natsutan/sting/vivado/zybo/zybo_sting/zybo_sting.ip_user_files/README.txt

The files in this directory structure are automatically generated and managed by Vivado. Editing these files is not recommended.
