natsutan/sting/vivado/zybo/sting_ip/sting_ip.srcs/sources_1/bd/design_1/ip/design_1_axi_vip_1_1/design_1_axi_vip_1_1_stub.v

// Copyright 1986-2017 Xilinx, Inc. All Rights Reserved.
// --------------------------------------------------------------------------------
// Tool Version: Vivado v.2017.2 (win64) Build 1909853 Thu Jun 15 18:39:09 MDT 2017
// Date        : Wed Dec 13 14:37:22 2017
// Host        : LAPTOP-NDAAQDUA running 64-bit major release  (build 9200)
// Command     : write_verilog -force -mode synth_stub
//               C:/home/myproj/sting/vivado/zybo/sting_ip/sting_ip.srcs/sources_1/bd/design_1/ip/design_1_axi_vip_1_1/design_1_axi_vip_1_1_stub.v
// Design      : design_1_axi_vip_1_1
// Purpose     : Stub declaration of top-level module interface
// Device      : xc7z010clg400-1
// --------------------------------------------------------------------------------

// This empty module with port declaration file causes synthesis tools to infer a black box for IP.
// The synthesis directives are for Synopsys Synplify support to prevent IO buffer insertion.
// Please paste the declaration into a Verilog source file or add the file as an additional source.
(* X_CORE_INFO = "axi_vip_v1_0_2_top,Vivado 2017.2" *)
module design_1_axi_vip_1_1(aclk, aresetn, s_axi_awid, s_axi_awaddr, 
  s_axi_awlen, s_axi_awburst, s_axi_awlock, s_axi_awcache, s_axi_awprot, s_axi_awqos, 
  s_axi_awuser, s_axi_awvalid, s_axi_awready, s_axi_wdata, s_axi_wstrb, s_axi_wlast, 
  s_axi_wuser, s_axi_wvalid, s_axi_wready, s_axi_bid, s_axi_bresp, s_axi_buser, s_axi_bvalid, 
  s_axi_bready, s_axi_arid, s_axi_araddr, s_axi_arlen, s_axi_arburst, s_axi_arlock, 
  s_axi_arcache, s_axi_arprot, s_axi_arqos, s_axi_aruser, s_axi_arvalid, s_axi_arready, 
  s_axi_rid, s_axi_rdata, s_axi_rresp, s_axi_rlast, s_axi_ruser, s_axi_rvalid, s_axi_rready)
/* synthesis syn_black_box black_box_pad_pin="aclk,aresetn,s_axi_awid[0:0],s_axi_awaddr[31:0],s_axi_awlen[7:0],s_axi_awburst[1:0],s_axi_awlock[0:0],s_axi_awcache[3:0],s_axi_awprot[2:0],s_axi_awqos[3:0],s_axi_awuser[0:0],s_axi_awvalid,s_axi_awready,s_axi_wdata[31:0],s_axi_wstrb[3:0],s_axi_wlast,s_axi_wuser[0:0],s_axi_wvalid,s_axi_wready,s_axi_bid[0:0],s_axi_bresp[1:0],s_axi_buser[0:0],s_axi_bvalid,s_axi_bready,s_axi_arid[0:0],s_axi_araddr[31:0],s_axi_arlen[7:0],s_axi_arburst[1:0],s_axi_arlock[0:0],s_axi_arcache[3:0],s_axi_arprot[2:0],s_axi_arqos[3:0],s_axi_aruser[0:0],s_axi_arvalid,s_axi_arready,s_axi_rid[0:0],s_axi_rdata[31:0],s_axi_rresp[1:0],s_axi_rlast,s_axi_ruser[0:0],s_axi_rvalid,s_axi_rready" */;
  input aclk;
  input aresetn;
  input [0:0]s_axi_awid;
  input [31:0]s_axi_awaddr;
  input [7:0]s_axi_awlen;
  input [1:0]s_axi_awburst;
  input [0:0]s_axi_awlock;
  input [3:0]s_axi_awcache;
  input [2:0]s_axi_awprot;
  input [3:0]s_axi_awqos;
  input [0:0]s_axi_awuser;
  input s_axi_awvalid;
  output s_axi_awready;
  input [31:0]s_axi_wdata;
  input [3:0]s_axi_wstrb;
  input s_axi_wlast;
  input [0:0]s_axi_wuser;
  input s_axi_wvalid;
  output s_axi_wready;
  output [0:0]s_axi_bid;
  output [1:0]s_axi_bresp;
  output [0:0]s_axi_buser;
  output s_axi_bvalid;
  input s_axi_bready;
  input [0:0]s_axi_arid;
  input [31:0]s_axi_araddr;
  input [7:0]s_axi_arlen;
  input [1:0]s_axi_arburst;
  input [0:0]s_axi_arlock;
  input [3:0]s_axi_arcache;
  input [2:0]s_axi_arprot;
  input [3:0]s_axi_arqos;
  input [0:0]s_axi_aruser;
  input s_axi_arvalid;
  output s_axi_arready;
  output [0:0]s_axi_rid;
  output [31:0]s_axi_rdata;
  output [1:0]s_axi_rresp;
  output s_axi_rlast;
  output [0:0]s_axi_ruser;
  output s_axi_rvalid;
  input s_axi_rready;
endmodule
