natsutan/sting/vivado/zybo/ip_repo/sting_wrap_1.0/src/float_mul/float_mul_sim_netlist.v

// Copyright 1986-2017 Xilinx, Inc. All Rights Reserved.
// --------------------------------------------------------------------------------
// Tool Version: Vivado v.2017.2 (win64) Build 1909853 Thu Jun 15 18:39:09 MDT 2017
// Date        : Mon Nov 27 00:59:39 2017
// Host        : LAPTOP-NDAAQDUA running 64-bit major release  (build 9200)
// Command     : write_verilog -force -mode funcsim
//               c:/home/myproj/sting/vivado/zybo/ip_repo/sting_wrap_1.0/src/float_mul/float_mul_sim_netlist.v
// Design      : float_mul
// Purpose     : This verilog netlist is a functional simulation representation of the design and should not be modified
//               or synthesized. This netlist cannot be used for SDF annotated simulation.
// Device      : xc7z010clg400-1
// --------------------------------------------------------------------------------
`timescale 1 ps / 1 ps

(* CHECK_LICENSE_TYPE = "float_mul,floating_point_v7_1_4,{}" *) (* downgradeipidentifiedwarnings = "yes" *) (* x_core_info = "floating_point_v7_1_4,Vivado 2017.2" *) 
(* NotValidForBitStream *)
module float_mul
   (aclk,
    s_axis_a_tvalid,
    s_axis_a_tdata,
    s_axis_b_tvalid,
    s_axis_b_tdata,
    m_axis_result_tvalid,
    m_axis_result_tdata);
  (* x_interface_info = "xilinx.com:signal:clock:1.0 aclk_intf CLK" *) input aclk;
  (* x_interface_info = "xilinx.com:interface:axis:1.0 S_AXIS_A TVALID" *) input s_axis_a_tvalid;
  (* x_interface_info = "xilinx.com:interface:axis:1.0 S_AXIS_A TDATA" *) input [31:0]s_axis_a_tdata;
  (* x_interface_info = "xilinx.com:interface:axis:1.0 S_AXIS_B TVALID" *) input s_axis_b_tvalid;
  (* x_interface_info = "xilinx.com:interface:axis:1.0 S_AXIS_B TDATA" *) input [31:0]s_axis_b_tdata;
  (* x_interface_info = "xilinx.com:interface:axis:1.0 M_AXIS_RESULT TVALID" *) output m_axis_result_tvalid;
  (* x_interface_info = "xilinx.com:interface:axis:1.0 M_AXIS_RESULT TDATA" *) output [31:0]m_axis_result_tdata;

  wire aclk;
  wire [31:0]m_axis_result_tdata;
  wire m_axis_result_tvalid;
  wire [31:0]s_axis_a_tdata;
  wire s_axis_a_tvalid;
  wire [31:0]s_axis_b_tdata;
  wire s_axis_b_tvalid;
  wire NLW_U0_m_axis_result_tlast_UNCONNECTED;
  wire NLW_U0_s_axis_a_tready_UNCONNECTED;
  wire NLW_U0_s_axis_b_tready_UNCONNECTED;
  wire NLW_U0_s_axis_c_tready_UNCONNECTED;
  wire NLW_U0_s_axis_operation_tready_UNCONNECTED;
  wire [0:0]NLW_U0_m_axis_result_tuser_UNCONNECTED;

  (* C_ACCUM_INPUT_MSB = "32" *) 
  (* C_ACCUM_LSB = "-31" *) 
  (* C_ACCUM_MSB = "32" *) 
  (* C_A_FRACTION_WIDTH = "24" *) 
  (* C_A_TDATA_WIDTH = "32" *) 
  (* C_A_TUSER_WIDTH = "1" *) 
  (* C_A_WIDTH = "32" *) 
  (* C_BRAM_USAGE = "0" *) 
  (* C_B_FRACTION_WIDTH = "24" *) 
  (* C_B_TDATA_WIDTH = "32" *) 
  (* C_B_TUSER_WIDTH = "1" *) 
  (* C_B_WIDTH = "32" *) 
  (* C_COMPARE_OPERATION = "8" *) 
  (* C_C_FRACTION_WIDTH = "24" *) 
  (* C_C_TDATA_WIDTH = "32" *) 
  (* C_C_TUSER_WIDTH = "1" *) 
  (* C_C_WIDTH = "32" *) 
  (* C_FIXED_DATA_UNSIGNED = "0" *) 
  (* C_HAS_ABSOLUTE = "0" *) 
  (* C_HAS_ACCUMULATOR_A = "0" *) 
  (* C_HAS_ACCUMULATOR_S = "0" *) 
  (* C_HAS_ACCUM_INPUT_OVERFLOW = "0" *) 
  (* C_HAS_ACCUM_OVERFLOW = "0" *) 
  (* C_HAS_ACLKEN = "0" *) 
  (* C_HAS_ADD = "0" *) 
  (* C_HAS_ARESETN = "0" *) 
  (* C_HAS_A_TLAST = "0" *) 
  (* C_HAS_A_TUSER = "0" *) 
  (* C_HAS_B = "1" *) 
  (* C_HAS_B_TLAST = "0" *) 
  (* C_HAS_B_TUSER = "0" *) 
  (* C_HAS_C = "0" *) 
  (* C_HAS_COMPARE = "0" *) 
  (* C_HAS_C_TLAST = "0" *) 
  (* C_HAS_C_TUSER = "0" *) 
  (* C_HAS_DIVIDE = "0" *) 
  (* C_HAS_DIVIDE_BY_ZERO = "0" *) 
  (* C_HAS_EXPONENTIAL = "0" *) 
  (* C_HAS_FIX_TO_FLT = "0" *) 
  (* C_HAS_FLT_TO_FIX = "0" *) 
  (* C_HAS_FLT_TO_FLT = "0" *) 
  (* C_HAS_FMA = "0" *) 
  (* C_HAS_FMS = "0" *) 
  (* C_HAS_INVALID_OP = "0" *) 
  (* C_HAS_LOGARITHM = "0" *) 
  (* C_HAS_MULTIPLY = "1" *) 
  (* C_HAS_OPERATION = "0" *) 
  (* C_HAS_OPERATION_TLAST = "0" *) 
  (* C_HAS_OPERATION_TUSER = "0" *) 
  (* C_HAS_OVERFLOW = "0" *) 
  (* C_HAS_RECIP = "0" *) 
  (* C_HAS_RECIP_SQRT = "0" *) 
  (* C_HAS_RESULT_TLAST = "0" *) 
  (* C_HAS_RESULT_TUSER = "0" *) 
  (* C_HAS_SQRT = "0" *) 
  (* C_HAS_SUBTRACT = "0" *) 
  (* C_HAS_UNDERFLOW = "0" *) 
  (* C_LATENCY = "8" *) 
  (* C_MULT_USAGE = "1" *) 
  (* C_OPERATION_TDATA_WIDTH = "8" *) 
  (* C_OPERATION_TUSER_WIDTH = "1" *) 
  (* C_OPTIMIZATION = "1" *) 
  (* C_RATE = "1" *) 
  (* C_RESULT_FRACTION_WIDTH = "24" *) 
  (* C_RESULT_TDATA_WIDTH = "32" *) 
  (* C_RESULT_TUSER_WIDTH = "1" *) 
  (* C_RESULT_WIDTH = "32" *) 
  (* C_THROTTLE_SCHEME = "3" *) 
  (* C_TLAST_RESOLUTION = "0" *) 
  (* C_XDEVICEFAMILY = "zynq" *) 
  (* downgradeipidentifiedwarnings = "yes" *) 
  float_mul_floating_point_v7_1_4 U0
       (.aclk(aclk),
        .aclken(1'b1),
        .aresetn(1'b1),
        .m_axis_result_tdata(m_axis_result_tdata),
        .m_axis_result_tlast(NLW_U0_m_axis_result_tlast_UNCONNECTED),
        .m_axis_result_tready(1'b0),
        .m_axis_result_tuser(NLW_U0_m_axis_result_tuser_UNCONNECTED[0]),
        .m_axis_result_tvalid(m_axis_result_tvalid),
        .s_axis_a_tdata(s_axis_a_tdata),
        .s_axis_a_tlast(1'b0),
        .s_axis_a_tready(NLW_U0_s_axis_a_tready_UNCONNECTED),
        .s_axis_a_tuser(1'b0),
        .s_axis_a_tvalid(s_axis_a_tvalid),
        .s_axis_b_tdata(s_axis_b_tdata),
        .s_axis_b_tlast(1'b0),
        .s_axis_b_tready(NLW_U0_s_axis_b_tready_UNCONNECTED),
        .s_axis_b_tuser(1'b0),
        .s_axis_b_tvalid(s_axis_b_tvalid),
        .s_axis_c_tdata({1'b0,1'b0,1'b0,1'b0,1'b0,1'b0,1'b0,1'b0,1'b0,1'b0,1'b0,1'b0,1'b0,1'b0,1'b0,1'b0,1'b0,1'b0,1'b0,1'b0,1'b0,1'b0,1'b0,1'b0,1'b0,1'b0,1'b0,1'b0,1'b0,1'b0,1'b0,1'b0}),
        .s_axis_c_tlast(1'b0),
        .s_axis_c_tready(NLW_U0_s_axis_c_tready_UNCONNECTED),
        .s_axis_c_tuser(1'b0),
        .s_axis_c_tvalid(1'b0),
        .s_axis_operation_tdata({1'b0,1'b0,1'b0,1'b0,1'b0,1'b0,1'b0,1'b0}),
        .s_axis_operation_tlast(1'b0),
        .s_axis_operation_tready(NLW_U0_s_axis_operation_tready_UNCONNECTED),
        .s_axis_operation_tuser(1'b0),
        .s_axis_operation_tvalid(1'b0));
endmodule

(* C_ACCUM_INPUT_MSB = "32" *) (* C_ACCUM_LSB = "-31" *) (* C_ACCUM_MSB = "32" *) 
(* C_A_FRACTION_WIDTH = "24" *) (* C_A_TDATA_WIDTH = "32" *) (* C_A_TUSER_WIDTH = "1" *) 
(* C_A_WIDTH = "32" *) (* C_BRAM_USAGE = "0" *) (* C_B_FRACTION_WIDTH = "24" *) 
(* C_B_TDATA_WIDTH = "32" *) (* C_B_TUSER_WIDTH = "1" *) (* C_B_WIDTH = "32" *) 
(* C_COMPARE_OPERATION = "8" *) (* C_C_FRACTION_WIDTH = "24" *) (* C_C_TDATA_WIDTH = "32" *) 
(* C_C_TUSER_WIDTH = "1" *) (* C_C_WIDTH = "32" *) (* C_FIXED_DATA_UNSIGNED = "0" *) 
(* C_HAS_ABSOLUTE = "0" *) (* C_HAS_ACCUMULATOR_A = "0" *) (* C_HAS_ACCUMULATOR_S = "0" *) 
(* C_HAS_ACCUM_INPUT_OVERFLOW = "0" *) (* C_HAS_ACCUM_OVERFLOW = "0" *) (* C_HAS_ACLKEN = "0" *) 
(* C_HAS_ADD = "0" *) (* C_HAS_ARESETN = "0" *) (* C_HAS_A_TLAST = "0" *) 
(* C_HAS_A_TUSER = "0" *) (* C_HAS_B = "1" *) (* C_HAS_B_TLAST = "0" *) 
(* C_HAS_B_TUSER = "0" *) (* C_HAS_C = "0" *) (* C_HAS_COMPARE = "0" *) 
(* C_HAS_C_TLAST = "0" *) (* C_HAS_C_TUSER = "0" *) (* C_HAS_DIVIDE = "0" *) 
(* C_HAS_DIVIDE_BY_ZERO = "0" *) (* C_HAS_EXPONENTIAL = "0" *) (* C_HAS_FIX_TO_FLT = "0" *) 
(* C_HAS_FLT_TO_FIX = "0" *) (* C_HAS_FLT_TO_FLT = "0" *) (* C_HAS_FMA = "0" *) 
(* C_HAS_FMS = "0" *) (* C_HAS_INVALID_OP = "0" *) (* C_HAS_LOGARITHM = "0" *) 
(* C_HAS_MULTIPLY = "1" *) (* C_HAS_OPERATION = "0" *) (* C_HAS_OPERATION_TLAST = "0" *) 
(* C_HAS_OPERATION_TUSER = "0" *) (* C_HAS_OVERFLOW = "0" *) (* C_HAS_RECIP = "0" *) 
(* C_HAS_RECIP_SQRT = "0" *) (* C_HAS_RESULT_TLAST = "0" *) (* C_HAS_RESULT_TUSER = "0" *) 
(* C_HAS_SQRT = "0" *) (* C_HAS_SUBTRACT = "0" *) (* C_HAS_UNDERFLOW = "0" *) 
(* C_LATENCY = "8" *) (* C_MULT_USAGE = "1" *) (* C_OPERATION_TDATA_WIDTH = "8" *) 
(* C_OPERATION_TUSER_WIDTH = "1" *) (* C_OPTIMIZATION = "1" *) (* C_RATE = "1" *) 
(* C_RESULT_FRACTION_WIDTH = "24" *) (* C_RESULT_TDATA_WIDTH = "32" *) (* C_RESULT_TUSER_WIDTH = "1" *) 
(* C_RESULT_WIDTH = "32" *) (* C_THROTTLE_SCHEME = "3" *) (* C_TLAST_RESOLUTION = "0" *) 
(* C_XDEVICEFAMILY = "zynq" *) (* ORIG_REF_NAME = "floating_point_v7_1_4" *) (* downgradeipidentifiedwarnings = "yes" *) 
module float_mul_floating_point_v7_1_4
   (aclk,
    aclken,
    aresetn,
    s_axis_a_tvalid,
    s_axis_a_tready,
    s_axis_a_tdata,
    s_axis_a_tuser,
    s_axis_a_tlast,
    s_axis_b_tvalid,
    s_axis_b_tready,
    s_axis_b_tdata,
    s_axis_b_tuser,
    s_axis_b_tlast,
    s_axis_c_tvalid,
    s_axis_c_tready,
    s_axis_c_tdata,
    s_axis_c_tuser,
    s_axis_c_tlast,
    s_axis_operation_tvalid,
    s_axis_operation_tready,
    s_axis_operation_tdata,
    s_axis_operation_tuser,
    s_axis_operation_tlast,
    m_axis_result_tvalid,
    m_axis_result_tready,
    m_axis_result_tdata,
    m_axis_result_tuser,
    m_axis_result_tlast);
  input aclk;
  input aclken;
  input aresetn;
  input s_axis_a_tvalid;
  output s_axis_a_tready;
  input [31:0]s_axis_a_tdata;
  input [0:0]s_axis_a_tuser;
  input s_axis_a_tlast;
  input s_axis_b_tvalid;
  output s_axis_b_tready;
  input [31:0]s_axis_b_tdata;
  input [0:0]s_axis_b_tuser;
  input s_axis_b_tlast;
  input s_axis_c_tvalid;
  output s_axis_c_tready;
  input [31:0]s_axis_c_tdata;
  input [0:0]s_axis_c_tuser;
  input s_axis_c_tlast;
  input s_axis_operation_tvalid;
  output s_axis_operation_tready;
  input [7:0]s_axis_operation_tdata;
  input [0:0]s_axis_operation_tuser;
  input s_axis_operation_tlast;
  output m_axis_result_tvalid;
  input m_axis_result_tready;
  output [31:0]m_axis_result_tdata;
  output [0:0]m_axis_result_tuser;
  output m_axis_result_tlast;

  wire \<const0> ;
  wire \<const1> ;
  wire aclk;
  wire [31:0]m_axis_result_tdata;
  wire m_axis_result_tvalid;
  wire [31:0]s_axis_a_tdata;
  wire s_axis_a_tvalid;
  wire [31:0]s_axis_b_tdata;
  wire s_axis_b_tvalid;
  wire NLW_i_synth_m_axis_result_tlast_UNCONNECTED;
  wire NLW_i_synth_s_axis_a_tready_UNCONNECTED;
  wire NLW_i_synth_s_axis_b_tready_UNCONNECTED;
  wire NLW_i_synth_s_axis_c_tready_UNCONNECTED;
  wire NLW_i_synth_s_axis_operation_tready_UNCONNECTED;
  wire [0:0]NLW_i_synth_m_axis_result_tuser_UNCONNECTED;

  assign m_axis_result_tlast = \<const0> ;
  assign m_axis_result_tuser[0] = \<const0> ;
  assign s_axis_a_tready = \<const1> ;
  assign s_axis_b_tready = \<const1> ;
  assign s_axis_c_tready = \<const1> ;
  assign s_axis_operation_tready = \<const1> ;
  GND GND
       (.G(\<const0> ));
  VCC VCC
       (.P(\<const1> ));
  (* C_ACCUM_INPUT_MSB = "32" *) 
  (* C_ACCUM_LSB = "-31" *) 
  (* C_ACCUM_MSB = "32" *) 
  (* C_A_FRACTION_WIDTH = "24" *) 
  (* C_A_TDATA_WIDTH = "32" *) 
  (* C_A_TUSER_WIDTH = "1" *) 
  (* C_A_WIDTH = "32" *) 
  (* C_BRAM_USAGE = "0" *) 
  (* C_B_FRACTION_WIDTH = "24" *) 
  (* C_B_TDATA_WIDTH = "32" *) 
  (* C_B_TUSER_WIDTH = "1" *) 
  (* C_B_WIDTH = "32" *) 
  (* C_COMPARE_OPERATION = "8" *) 
  (* C_C_FRACTION_WIDTH = "24" *) 
  (* C_C_TDATA_WIDTH = "32" *) 
  (* C_C_TUSER_WIDTH = "1" *) 
  (* C_C_WIDTH = "32" *) 
  (* C_FIXED_DATA_UNSIGNED = "0" *) 
  (* C_HAS_ABSOLUTE = "0" *) 
  (* C_HAS_ACCUMULATOR_A = "0" *) 
  (* C_HAS_ACCUMULATOR_S = "0" *) 
  (* C_HAS_ACCUM_INPUT_OVERFLOW = "0" *) 
  (* C_HAS_ACCUM_OVERFLOW = "0" *) 
  (* C_HAS_ACLKEN = "0" *) 
  (* C_HAS_ADD = "0" *) 
  (* C_HAS_ARESETN = "0" *) 
  (* C_HAS_A_TLAST = "0" *) 
  (* C_HAS_A_TUSER = "0" *) 
  (* C_HAS_B = "1" *) 
  (* C_HAS_B_TLAST = "0" *) 
  (* C_HAS_B_TUSER = "0" *) 
  (* C_HAS_C = "0" *) 
  (* C_HAS_COMPARE = "0" *) 
  (* C_HAS_C_TLAST = "0" *) 
  (* C_HAS_C_TUSER = "0" *) 
  (* C_HAS_DIVIDE = "0" *) 
  (* C_HAS_DIVIDE_BY_ZERO = "0" *) 
  (* C_HAS_EXPONENTIAL = "0" *) 
  (* C_HAS_FIX_TO_FLT = "0" *) 
  (* C_HAS_FLT_TO_FIX = "0" *) 
  (* C_HAS_FLT_TO_FLT = "0" *) 
  (* C_HAS_FMA = "0" *) 
  (* C_HAS_FMS = "0" *) 
  (* C_HAS_INVALID_OP = "0" *) 
  (* C_HAS_LOGARITHM = "0" *) 
  (* C_HAS_MULTIPLY = "1" *) 
  (* C_HAS_OPERATION = "0" *) 
  (* C_HAS_OPERATION_TLAST = "0" *) 
  (* C_HAS_OPERATION_TUSER = "0" *) 
  (* C_HAS_OVERFLOW = "0" *) 
  (* C_HAS_RECIP = "0" *) 
  (* C_HAS_RECIP_SQRT = "0" *) 
  (* C_HAS_RESULT_TLAST = "0" *) 
  (* C_HAS_RESULT_TUSER = "0" *) 
  (* C_HAS_SQRT = "0" *) 
  (* C_HAS_SUBTRACT = "0" *) 
  (* C_HAS_UNDERFLOW = "0" *) 
  (* C_LATENCY = "8" *) 
  (* C_MULT_USAGE = "1" *) 
  (* C_OPERATION_TDATA_WIDTH = "8" *) 
  (* C_OPERATION_TUSER_WIDTH = "1" *) 
  (* C_OPTIMIZATION = "1" *) 
  (* C_RATE = "1" *) 
  (* C_RESULT_FRACTION_WIDTH = "24" *) 
  (* C_RESULT_TDATA_WIDTH = "32" *) 
  (* C_RESULT_TUSER_WIDTH = "1" *) 
  (* C_RESULT_WIDTH = "32" *) 
  (* C_THROTTLE_SCHEME = "3" *) 
  (* C_TLAST_RESOLUTION = "0" *) 
  (* C_XDEVICEFAMILY = "zynq" *) 
  (* downgradeipidentifiedwarnings = "yes" *) 
  float_mul_floating_point_v7_1_4_viv i_synth
       (.aclk(aclk),
        .aclken(1'b0),
        .aresetn(1'b0),
        .m_axis_result_tdata(m_axis_result_tdata),
        .m_axis_result_tlast(NLW_i_synth_m_axis_result_tlast_UNCONNECTED),
        .m_axis_result_tready(1'b0),
        .m_axis_result_tuser(NLW_i_synth_m_axis_result_tuser_UNCONNECTED[0]),
        .m_axis_result_tvalid(m_axis_result_tvalid),
        .s_axis_a_tdata(s_axis_a_tdata),
        .s_axis_a_tlast(1'b0),
        .s_axis_a_tready(NLW_i_synth_s_axis_a_tready_UNCONNECTED),
        .s_axis_a_tuser(1'b0),
        .s_axis_a_tvalid(s_axis_a_tvalid),
        .s_axis_b_tdata(s_axis_b_tdata),
        .s_axis_b_tlast(1'b0),
        .s_axis_b_tready(NLW_i_synth_s_axis_b_tready_UNCONNECTED),
        .s_axis_b_tuser(1'b0),
        .s_axis_b_tvalid(s_axis_b_tvalid),
        .s_axis_c_tdata({1'b0,1'b0,1'b0,1'b0,1'b0,1'b0,1'b0,1'b0,1'b0,1'b0,1'b0,1'b0,1'b0,1'b0,1'b0,1'b0,1'b0,1'b0,1'b0,1'b0,1'b0,1'b0,1'b0,1'b0,1'b0,1'b0,1'b0,1'b0,1'b0,1'b0,1'b0,1'b0}),
        .s_axis_c_tlast(1'b0),
        .s_axis_c_tready(NLW_i_synth_s_axis_c_tready_UNCONNECTED),
        .s_axis_c_tuser(1'b0),
        .s_axis_c_tvalid(1'b0),
        .s_axis_operation_tdata({1'b0,1'b0,1'b0,1'b0,1'b0,1'b0,1'b0,1'b0}),
        .s_axis_operation_tlast(1'b0),
        .s_axis_operation_tready(NLW_i_synth_s_axis_operation_tready_UNCONNECTED),
        .s_axis_operation_tuser(1'b0),
        .s_axis_operation_tvalid(1'b0));
endmodule
`pragma protect begin_protected
`pragma protect version = 1
`pragma protect encrypt_agent = "XILINX"
`pragma protect encrypt_agent_info = "Xilinx Encryption Tool 2015"
`pragma protect key_keyowner="Cadence Design Systems.", key_keyname="cds_rsa_key", key_method="rsa"
`pragma protect encoding = (enctype="BASE64", line_length=76, bytes=64)
`pragma protect key_block
gMnNDB7HJ7donIJbcM6QEJhs7GvsLZQGaLvOD/fPlyeIjj7Rj/lJ4gT0tXZQEcBxPDk1lgtQTzhA
aTf8smsH3w==

`pragma protect key_keyowner="Mentor Graphics Corporation", key_keyname="MGC-VERIF-SIM-RSA-1", key_method="rsa"
`pragma protect encoding = (enctype="BASE64", line_length=76, bytes=128)
`pragma protect key_block
k6o4s8ezPOdGLPCxBhj7yeIjEH8po60eJ5YNYMKGXXYdLD898CcAAw0EvrHsivJvDr0ryU+aVO4w
CWcCTxUt8pReAUAa9H9+RdDfSxUQb03nJOyGX2wJS6DEELXD1eq/OEehI/ziKnZ59rBG0UIIgZvC
yPtECONoLcc2TBKYb6c=

`pragma protect key_keyowner="Synopsys", key_keyname="SNPS-VCS-RSA-1", key_method="rsa"
`pragma protect encoding = (enctype="BASE64", line_length=76, bytes=128)
`pragma protect key_block
MZA/t6b5vV7s0J+J5RLdbP6PHUxxDkvU08bTG1vLsBX67qKX4U+C3Wsx6TNN0okYEct8Xkhb289N
JtbWq4kXIQYcn4CwCvLm8yhSxQ2XwXJns7fUib9wYsgXQ3rnAGFrKv1HuyFXVcOBtfP2wkYqXpeD
CTyvlqfurrqUWmQ7UKk=

`pragma protect key_keyowner="Aldec", key_keyname="ALDEC15_001", key_method="rsa"
`pragma protect encoding = (enctype="BASE64", line_length=76, bytes=256)
`pragma protect key_block
Mp+/Q6a3N6nCHeNhCdRUBgQqepFSqeLYU4EqRdXf6mDSGy/4oTzTrCxFpZcmf7PS2LUou6tA6wBP
eCGOEZslD/aY7bVbNvSz1gv2x2NkzOuEi6ryFILivy6r7eSfTN1a1uYk48oGl70aYtw6LHTredUU
eFovuGVMSp1e3Zh66f7vArqfO6zDJlwXnKW+B1DNyWj4p929QNU2+RN0enU+E1S4wm7g5+0BgdT+
rmPX0Jsl0bIWKAIzRzlmvcNvzsFtlNgnuNJ+GKCL6+tseDcn5Z8u42lKQqVT6MjqDn/VQgGHNsfM
VBfZdVLsbkAkwAlXVZOcdCxuw79rVZcpJhYJGg==

`pragma protect key_keyowner="ATRENTA", key_keyname="ATR-SG-2015-RSA-3", key_method="rsa"
`pragma protect encoding = (enctype="BASE64", line_length=76, bytes=256)
`pragma protect key_block
YIEIm2lOi+fRHHM+EO3dxSj9n30vPGFIo8XEFyIzZoZAMHs1UOzKM23/GkgzZxBFxJfMyS/d7ArR
WRjQ8UXAmzk4HktLauXbBeWobuq4mV6lDpTjn77TXtZtpxauNJv/aYAdtjdPI3KDUQCs7szWuaet
9ydMZarsImfgB0Y5UfmropJ7T6Am0oAgn1P1KQ+WuIEQ236WOk9UPmVeKORSrq5f1NAh+Y3QJX/r
HDbglZ2bVDSwPmnMSAShLLojJrd87TRlcODcA2mbQB/VzBkBdCdMlziL7Zv2e/8a0f8S8ZY6KkNe
P4g3C+zb0R7FWBPpKdhuwgod8I1RIyoCzGsIfg==

`pragma protect key_keyowner="Xilinx", key_keyname="xilinx_2016_05", key_method="rsa"
`pragma protect encoding = (enctype="BASE64", line_length=76, bytes=256)
`pragma protect key_block
Ol11igo6uicyQPMv3TYh1e1YZsG97VgcnA0AsEZ4d4vgXZ98mVZHNSPN/7odE2GZE1OrUsPN+DcN
Bzi1mQW4iJ6zTFV0CUlTQ3GPjgKMf2jmTfTENWjprFYdcW+NW2siwWbCP+FCVAS7ytx/FWuRYwSI
8BI1VqamYS2FUnk4WzsF4HwMShp3QNuWuVKvbjsikYPj6EVkt8zba31pUhT151lw/GGlvD2nj+wF
VXr/XYoQCJuXCKDWw7Gh2mkeHRpvS1rwiQtutUNoIRN9gcL8Ti2cnaxEHmdAY6Rs/QJsznVWLgzm
pLckE1T683mQn4gGbbtKAASGBxVM5hQyK5VEjg==

`pragma protect key_keyowner="Mentor Graphics Corporation", key_keyname="MGC-PREC-RSA", key_method="rsa"
`pragma protect encoding = (enctype="base64", line_length=76, bytes=256)
`pragma protect key_block
MUQ7fRa/H45SILniL07Vwx1ShdRaTSVaDxGG215umWqkK/ui1H9Myqx04LoWTXNyBP1zxsRpJUO0
F7eMkTaxG5Fdz9wjR71WL52tL/ZywaAPv7VbBxmcjIEWzDXYSE1c/HAx9+xneua03AukERkIr0Hb
z69ZUyqOVUjn5PnP6TxzJoXomsLWPEH224w0J2ivHJD6NnXVRPLxMY7XoX62SifVYzXgwYfrMlIO
WT6DROyVd2MJ25sySeS5b3KtjejLR1Fq3EVHbCA95hj+/O/EcEdQVZW397VitN5BwAWgNb5ykujH
tG1Yw3AFRwWtelHt1FwrPHzyZRroq+5hoN9Q3w==

`pragma protect key_keyowner="Synplicity", key_keyname="SYNP15_1", key_method="rsa"
`pragma protect encoding = (enctype="base64", line_length=76, bytes=256)
`pragma protect key_block
icKqGC+FyncnGj/Z16fMBPy61Ql9p6giCgTNaGZIfLVhBsp76nNn8iRYgvMRixZvPYclZWjLiN6O
kp1i5piy+bxWqB7GTYaQbk+BIm2VGo3RMBKmf1PkNTuISVEwILNsHAmJfyhjhcN+F7JoSNDp6j2M
vouKQkkosrnQlOESFHAB/gOfkSsxnSCybEZxM2gJVWVIu+Q1mfMu4cVhbvgEcfmqoXJvDK7zyYJh
dje2OUc6GPpLVd0EMIMOJAov4qh/EzCCUh/uL2CwssoLYczlaGW2fe37rjmegLp7wCeFjZnIH1JB
uITnGGHoi3u5ieqliAJov4b3DVRWfnpOvsCqoQ==

`pragma protect data_method = "AES128-CBC"
`pragma protect encoding = (enctype = "BASE64", line_length = 76, bytes = 336624)
`pragma protect data_block
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
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
