natsutan/sting/vivado/zybo/sting_ip/sting_ip.srcs/sources_1/bd/design_1/ip/design_1_axi_vip_0_1/design_1_axi_vip_0_1_sim_netlist.v

// Copyright 1986-2017 Xilinx, Inc. All Rights Reserved.
// --------------------------------------------------------------------------------
// Tool Version: Vivado v.2017.2 (win64) Build 1909853 Thu Jun 15 18:39:09 MDT 2017
// Date        : Wed Dec 13 14:36:33 2017
// Host        : LAPTOP-NDAAQDUA running 64-bit major release  (build 9200)
// Command     : write_verilog -force -mode funcsim
//               C:/home/myproj/sting/vivado/zybo/sting_ip/sting_ip.srcs/sources_1/bd/design_1/ip/design_1_axi_vip_0_1/design_1_axi_vip_0_1_sim_netlist.v
// Design      : design_1_axi_vip_0_1
// Purpose     : This verilog netlist is a functional simulation representation of the design and should not be modified
//               or synthesized. This netlist cannot be used for SDF annotated simulation.
// Device      : xc7z010clg400-1
// --------------------------------------------------------------------------------
`timescale 1 ps / 1 ps

(* CHECK_LICENSE_TYPE = "design_1_axi_vip_0_1,axi_vip_v1_0_2_top,{}" *) (* DowngradeIPIdentifiedWarnings = "yes" *) (* X_CORE_INFO = "axi_vip_v1_0_2_top,Vivado 2017.2" *) 
(* NotValidForBitStream *)
module design_1_axi_vip_0_1
   (aclk,
    aresetn,
    m_axi_awaddr,
    m_axi_awprot,
    m_axi_awvalid,
    m_axi_awready,
    m_axi_wdata,
    m_axi_wstrb,
    m_axi_wvalid,
    m_axi_wready,
    m_axi_bresp,
    m_axi_bvalid,
    m_axi_bready,
    m_axi_araddr,
    m_axi_arprot,
    m_axi_arvalid,
    m_axi_arready,
    m_axi_rdata,
    m_axi_rresp,
    m_axi_rvalid,
    m_axi_rready);
  (* X_INTERFACE_INFO = "xilinx.com:signal:clock:1.0 CLOCK CLK" *) input aclk;
  (* X_INTERFACE_INFO = "xilinx.com:signal:reset:1.0 RESET RST" *) input aresetn;
  (* X_INTERFACE_INFO = "xilinx.com:interface:aximm:1.0 M_AXI AWADDR" *) output [31:0]m_axi_awaddr;
  (* X_INTERFACE_INFO = "xilinx.com:interface:aximm:1.0 M_AXI AWPROT" *) output [2:0]m_axi_awprot;
  (* X_INTERFACE_INFO = "xilinx.com:interface:aximm:1.0 M_AXI AWVALID" *) output m_axi_awvalid;
  (* X_INTERFACE_INFO = "xilinx.com:interface:aximm:1.0 M_AXI AWREADY" *) input m_axi_awready;
  (* X_INTERFACE_INFO = "xilinx.com:interface:aximm:1.0 M_AXI WDATA" *) output [31:0]m_axi_wdata;
  (* X_INTERFACE_INFO = "xilinx.com:interface:aximm:1.0 M_AXI WSTRB" *) output [3:0]m_axi_wstrb;
  (* X_INTERFACE_INFO = "xilinx.com:interface:aximm:1.0 M_AXI WVALID" *) output m_axi_wvalid;
  (* X_INTERFACE_INFO = "xilinx.com:interface:aximm:1.0 M_AXI WREADY" *) input m_axi_wready;
  (* X_INTERFACE_INFO = "xilinx.com:interface:aximm:1.0 M_AXI BRESP" *) input [1:0]m_axi_bresp;
  (* X_INTERFACE_INFO = "xilinx.com:interface:aximm:1.0 M_AXI BVALID" *) input m_axi_bvalid;
  (* X_INTERFACE_INFO = "xilinx.com:interface:aximm:1.0 M_AXI BREADY" *) output m_axi_bready;
  (* X_INTERFACE_INFO = "xilinx.com:interface:aximm:1.0 M_AXI ARADDR" *) output [31:0]m_axi_araddr;
  (* X_INTERFACE_INFO = "xilinx.com:interface:aximm:1.0 M_AXI ARPROT" *) output [2:0]m_axi_arprot;
  (* X_INTERFACE_INFO = "xilinx.com:interface:aximm:1.0 M_AXI ARVALID" *) output m_axi_arvalid;
  (* X_INTERFACE_INFO = "xilinx.com:interface:aximm:1.0 M_AXI ARREADY" *) input m_axi_arready;
  (* X_INTERFACE_INFO = "xilinx.com:interface:aximm:1.0 M_AXI RDATA" *) input [31:0]m_axi_rdata;
  (* X_INTERFACE_INFO = "xilinx.com:interface:aximm:1.0 M_AXI RRESP" *) input [1:0]m_axi_rresp;
  (* X_INTERFACE_INFO = "xilinx.com:interface:aximm:1.0 M_AXI RVALID" *) input m_axi_rvalid;
  (* X_INTERFACE_INFO = "xilinx.com:interface:aximm:1.0 M_AXI RREADY" *) output m_axi_rready;

  wire aclk;
  wire aresetn;
  wire [31:0]m_axi_araddr;
  wire [2:0]m_axi_arprot;
  wire m_axi_arready;
  wire m_axi_arvalid;
  wire [31:0]m_axi_awaddr;
  wire [2:0]m_axi_awprot;
  wire m_axi_awready;
  wire m_axi_awvalid;
  wire m_axi_bready;
  wire [1:0]m_axi_bresp;
  wire m_axi_bvalid;
  wire [31:0]m_axi_rdata;
  wire m_axi_rready;
  wire [1:0]m_axi_rresp;
  wire m_axi_rvalid;
  wire [31:0]m_axi_wdata;
  wire m_axi_wready;
  wire [3:0]m_axi_wstrb;
  wire m_axi_wvalid;
  wire NLW_inst_m_axi_wlast_UNCONNECTED;
  wire NLW_inst_s_axi_arready_UNCONNECTED;
  wire NLW_inst_s_axi_awready_UNCONNECTED;
  wire NLW_inst_s_axi_bvalid_UNCONNECTED;
  wire NLW_inst_s_axi_rlast_UNCONNECTED;
  wire NLW_inst_s_axi_rvalid_UNCONNECTED;
  wire NLW_inst_s_axi_wready_UNCONNECTED;
  wire [1:0]NLW_inst_m_axi_arburst_UNCONNECTED;
  wire [3:0]NLW_inst_m_axi_arcache_UNCONNECTED;
  wire [0:0]NLW_inst_m_axi_arid_UNCONNECTED;
  wire [7:0]NLW_inst_m_axi_arlen_UNCONNECTED;
  wire [0:0]NLW_inst_m_axi_arlock_UNCONNECTED;
  wire [3:0]NLW_inst_m_axi_arqos_UNCONNECTED;
  wire [3:0]NLW_inst_m_axi_arregion_UNCONNECTED;
  wire [2:0]NLW_inst_m_axi_arsize_UNCONNECTED;
  wire [0:0]NLW_inst_m_axi_aruser_UNCONNECTED;
  wire [1:0]NLW_inst_m_axi_awburst_UNCONNECTED;
  wire [3:0]NLW_inst_m_axi_awcache_UNCONNECTED;
  wire [0:0]NLW_inst_m_axi_awid_UNCONNECTED;
  wire [7:0]NLW_inst_m_axi_awlen_UNCONNECTED;
  wire [0:0]NLW_inst_m_axi_awlock_UNCONNECTED;
  wire [3:0]NLW_inst_m_axi_awqos_UNCONNECTED;
  wire [3:0]NLW_inst_m_axi_awregion_UNCONNECTED;
  wire [2:0]NLW_inst_m_axi_awsize_UNCONNECTED;
  wire [0:0]NLW_inst_m_axi_awuser_UNCONNECTED;
  wire [0:0]NLW_inst_m_axi_wid_UNCONNECTED;
  wire [0:0]NLW_inst_m_axi_wuser_UNCONNECTED;
  wire [0:0]NLW_inst_s_axi_bid_UNCONNECTED;
  wire [1:0]NLW_inst_s_axi_bresp_UNCONNECTED;
  wire [0:0]NLW_inst_s_axi_buser_UNCONNECTED;
  wire [31:0]NLW_inst_s_axi_rdata_UNCONNECTED;
  wire [0:0]NLW_inst_s_axi_rid_UNCONNECTED;
  wire [1:0]NLW_inst_s_axi_rresp_UNCONNECTED;
  wire [0:0]NLW_inst_s_axi_ruser_UNCONNECTED;

  (* C_AXI_ADDR_WIDTH = "32" *) 
  (* C_AXI_ARUSER_WIDTH = "0" *) 
  (* C_AXI_AWUSER_WIDTH = "0" *) 
  (* C_AXI_BUSER_WIDTH = "0" *) 
  (* C_AXI_HAS_ARESETN = "1" *) 
  (* C_AXI_HAS_BRESP = "1" *) 
  (* C_AXI_HAS_BURST = "0" *) 
  (* C_AXI_HAS_CACHE = "0" *) 
  (* C_AXI_HAS_LOCK = "0" *) 
  (* C_AXI_HAS_PROT = "1" *) 
  (* C_AXI_HAS_QOS = "0" *) 
  (* C_AXI_HAS_REGION = "0" *) 
  (* C_AXI_HAS_RRESP = "1" *) 
  (* C_AXI_HAS_WSTRB = "1" *) 
  (* C_AXI_INTERFACE_MODE = "0" *) 
  (* C_AXI_PROTOCOL = "2" *) 
  (* C_AXI_RDATA_WIDTH = "32" *) 
  (* C_AXI_RID_WIDTH = "0" *) 
  (* C_AXI_RUSER_WIDTH = "0" *) 
  (* C_AXI_SUPPORTS_NARROW = "0" *) 
  (* C_AXI_WDATA_WIDTH = "32" *) 
  (* C_AXI_WID_WIDTH = "0" *) 
  (* C_AXI_WUSER_WIDTH = "0" *) 
  (* DowngradeIPIdentifiedWarnings = "yes" *) 
  design_1_axi_vip_0_1_axi_vip_v1_0_2_top inst
       (.aclk(aclk),
        .aclken(1'b1),
        .aresetn(aresetn),
        .m_axi_araddr(m_axi_araddr),
        .m_axi_arburst(NLW_inst_m_axi_arburst_UNCONNECTED[1:0]),
        .m_axi_arcache(NLW_inst_m_axi_arcache_UNCONNECTED[3:0]),
        .m_axi_arid(NLW_inst_m_axi_arid_UNCONNECTED[0]),
        .m_axi_arlen(NLW_inst_m_axi_arlen_UNCONNECTED[7:0]),
        .m_axi_arlock(NLW_inst_m_axi_arlock_UNCONNECTED[0]),
        .m_axi_arprot(m_axi_arprot),
        .m_axi_arqos(NLW_inst_m_axi_arqos_UNCONNECTED[3:0]),
        .m_axi_arready(m_axi_arready),
        .m_axi_arregion(NLW_inst_m_axi_arregion_UNCONNECTED[3:0]),
        .m_axi_arsize(NLW_inst_m_axi_arsize_UNCONNECTED[2:0]),
        .m_axi_aruser(NLW_inst_m_axi_aruser_UNCONNECTED[0]),
        .m_axi_arvalid(m_axi_arvalid),
        .m_axi_awaddr(m_axi_awaddr),
        .m_axi_awburst(NLW_inst_m_axi_awburst_UNCONNECTED[1:0]),
        .m_axi_awcache(NLW_inst_m_axi_awcache_UNCONNECTED[3:0]),
        .m_axi_awid(NLW_inst_m_axi_awid_UNCONNECTED[0]),
        .m_axi_awlen(NLW_inst_m_axi_awlen_UNCONNECTED[7:0]),
        .m_axi_awlock(NLW_inst_m_axi_awlock_UNCONNECTED[0]),
        .m_axi_awprot(m_axi_awprot),
        .m_axi_awqos(NLW_inst_m_axi_awqos_UNCONNECTED[3:0]),
        .m_axi_awready(m_axi_awready),
        .m_axi_awregion(NLW_inst_m_axi_awregion_UNCONNECTED[3:0]),
        .m_axi_awsize(NLW_inst_m_axi_awsize_UNCONNECTED[2:0]),
        .m_axi_awuser(NLW_inst_m_axi_awuser_UNCONNECTED[0]),
        .m_axi_awvalid(m_axi_awvalid),
        .m_axi_bid(1'b0),
        .m_axi_bready(m_axi_bready),
        .m_axi_bresp(m_axi_bresp),
        .m_axi_buser(1'b0),
        .m_axi_bvalid(m_axi_bvalid),
        .m_axi_rdata(m_axi_rdata),
        .m_axi_rid(1'b0),
        .m_axi_rlast(1'b0),
        .m_axi_rready(m_axi_rready),
        .m_axi_rresp(m_axi_rresp),
        .m_axi_ruser(1'b0),
        .m_axi_rvalid(m_axi_rvalid),
        .m_axi_wdata(m_axi_wdata),
        .m_axi_wid(NLW_inst_m_axi_wid_UNCONNECTED[0]),
        .m_axi_wlast(NLW_inst_m_axi_wlast_UNCONNECTED),
        .m_axi_wready(m_axi_wready),
        .m_axi_wstrb(m_axi_wstrb),
        .m_axi_wuser(NLW_inst_m_axi_wuser_UNCONNECTED[0]),
        .m_axi_wvalid(m_axi_wvalid),
        .s_axi_araddr({1'b0,1'b0,1'b0,1'b0,1'b0,1'b0,1'b0,1'b0,1'b0,1'b0,1'b0,1'b0,1'b0,1'b0,1'b0,1'b0,1'b0,1'b0,1'b0,1'b0,1'b0,1'b0,1'b0,1'b0,1'b0,1'b0,1'b0,1'b0,1'b0,1'b0,1'b0,1'b0}),
        .s_axi_arburst({1'b0,1'b1}),
        .s_axi_arcache({1'b0,1'b0,1'b0,1'b0}),
        .s_axi_arid(1'b0),
        .s_axi_arlen({1'b0,1'b0,1'b0,1'b0,1'b0,1'b0,1'b0,1'b0}),
        .s_axi_arlock(1'b0),
        .s_axi_arprot({1'b0,1'b0,1'b0}),
        .s_axi_arqos({1'b0,1'b0,1'b0,1'b0}),
        .s_axi_arready(NLW_inst_s_axi_arready_UNCONNECTED),
        .s_axi_arregion({1'b0,1'b0,1'b0,1'b0}),
        .s_axi_arsize({1'b0,1'b1,1'b0}),
        .s_axi_aruser(1'b0),
        .s_axi_arvalid(1'b0),
        .s_axi_awaddr({1'b0,1'b0,1'b0,1'b0,1'b0,1'b0,1'b0,1'b0,1'b0,1'b0,1'b0,1'b0,1'b0,1'b0,1'b0,1'b0,1'b0,1'b0,1'b0,1'b0,1'b0,1'b0,1'b0,1'b0,1'b0,1'b0,1'b0,1'b0,1'b0,1'b0,1'b0,1'b0}),
        .s_axi_awburst({1'b0,1'b1}),
        .s_axi_awcache({1'b0,1'b0,1'b0,1'b0}),
        .s_axi_awid(1'b0),
        .s_axi_awlen({1'b0,1'b0,1'b0,1'b0,1'b0,1'b0,1'b0,1'b0}),
        .s_axi_awlock(1'b0),
        .s_axi_awprot({1'b0,1'b0,1'b0}),
        .s_axi_awqos({1'b0,1'b0,1'b0,1'b0}),
        .s_axi_awready(NLW_inst_s_axi_awready_UNCONNECTED),
        .s_axi_awregion({1'b0,1'b0,1'b0,1'b0}),
        .s_axi_awsize({1'b0,1'b1,1'b0}),
        .s_axi_awuser(1'b0),
        .s_axi_awvalid(1'b0),
        .s_axi_bid(NLW_inst_s_axi_bid_UNCONNECTED[0]),
        .s_axi_bready(1'b0),
        .s_axi_bresp(NLW_inst_s_axi_bresp_UNCONNECTED[1:0]),
        .s_axi_buser(NLW_inst_s_axi_buser_UNCONNECTED[0]),
        .s_axi_bvalid(NLW_inst_s_axi_bvalid_UNCONNECTED),
        .s_axi_rdata(NLW_inst_s_axi_rdata_UNCONNECTED[31:0]),
        .s_axi_rid(NLW_inst_s_axi_rid_UNCONNECTED[0]),
        .s_axi_rlast(NLW_inst_s_axi_rlast_UNCONNECTED),
        .s_axi_rready(1'b0),
        .s_axi_rresp(NLW_inst_s_axi_rresp_UNCONNECTED[1:0]),
        .s_axi_ruser(NLW_inst_s_axi_ruser_UNCONNECTED[0]),
        .s_axi_rvalid(NLW_inst_s_axi_rvalid_UNCONNECTED),
        .s_axi_wdata({1'b0,1'b0,1'b0,1'b0,1'b0,1'b0,1'b0,1'b0,1'b0,1'b0,1'b0,1'b0,1'b0,1'b0,1'b0,1'b0,1'b0,1'b0,1'b0,1'b0,1'b0,1'b0,1'b0,1'b0,1'b0,1'b0,1'b0,1'b0,1'b0,1'b0,1'b0,1'b0}),
        .s_axi_wid(1'b0),
        .s_axi_wlast(1'b0),
        .s_axi_wready(NLW_inst_s_axi_wready_UNCONNECTED),
        .s_axi_wstrb({1'b1,1'b1,1'b1,1'b1}),
        .s_axi_wuser(1'b0),
        .s_axi_wvalid(1'b0));
endmodule
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
