natsutan/sting/(commit log)

2017-11-23 表の修正
2017-11-24 変数定義追加
2017-11-24 動作シーケンス追加
2017-11-26 ファイル追加
2017-11-27 parameter追加
2017-11-27 入出力追加
2017-11-28 波形追加
2017-11-28 wave追加
2017-11-28 重みの波形追加
2017-11-28 AXI RW追加
2017-11-28 CC2_DSP3x3記述追加
2017-11-30 画像ファイルの移動
2017-12-01 レジスタ追加
2017-12-01 レジスタ記述
2017-12-17 tabの修正
2017-12-17 レジスタ部コーディング
    誤字修正
    制御部からレジスタにカウントを渡すように修正
2017-12-17 レジスタR/Wデバッグ中
    アドレスのずれがあるので動いていない
2017-12-18 レジスタ修正
2017-12-18 レジスタwriteテスト
2017-12-18 レジスタのライトテスト環境作成
2017-12-18 レジスタライトのエラー修正（2カ所）
    REG_AXI_RW_OUTPUT_XSIZEとREG_AXI_RW_OUTPUT_START_ADRが逆になっていたのを修正
2017-12-18 レジスタライト試験PASS
    アドレスの入れ子を修正
    期待値間違いを修正
2017-12-18 新しいテストパターン追加
2017-12-20 レジスタ部分のバグ修正
    runとソフトリセットのパルスが上手く作れてなかった。
2017-12-20 ウェイト読み出しのテストパターン追加
2017-12-25 AXIリード回路の作成
    テストベンチの拡張子変更
    9回リードする回路作成
2017-12-25 コンパイルエラーを無くした
2017-12-25 AXI WEGHTのリードが1回できるようになった。
2017-12-28 sim環境構築中
2017-12-28 ファイル移動
2017-12-28 ファイル削除
2017-12-29 比較スクリプト作成
2017-12-30 最初のリードデータの更新タイミングがおかしい不具合修正
2017-12-30 読み出しデータが一部変化しないバグ修正
    重みの数がおかしい。
2017-12-30 とりあえずテストは通った
    BN_ENの制御に制限あり。（ドキュメント追加必要）
2017-12-30 ドキュメント整理
2018-01-04 データ追加
